zrecore/Garden_Light_Base_Glosola_HSS1751/models/renders/Glosola_HSS1751.6PK_Base_showcase.png

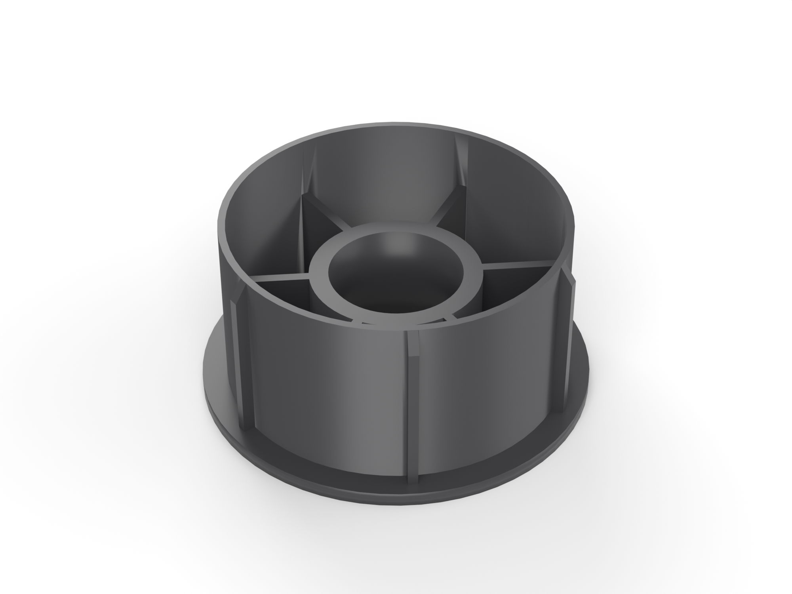
models/renders/Glosola_HSS1751.6PK_Base_showcase.png
