zrecore/Garden_Light_Base_Glosola_HSS1751/models/print/Glosola_HSS1751.6PK-Glosola_HSS1751.6PK_Base.3mf

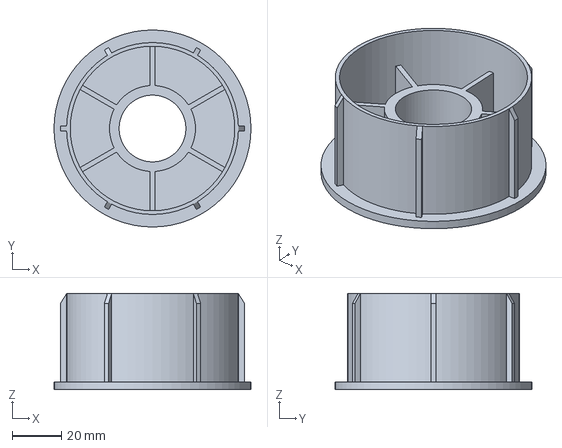
[picture p5: CAD file, 2026-11-03]
models/print/Glosola_HSS1751.6PK-Glosola_HSS1751.6PK_Base.3mf
80.0 x 80.0 x 39.0 mm
