zrecore/Garden_Light_Base_Glosola_HSS1751/(list of files, cad)

Other CAD files:
models/Glosola_HSS1751.6PK.blend
models/print/Glosola_HSS1751.6PK-Glosola_HSS1751.6PK_Base.obj
