zrecore/Garden_Light_Base_Glosola_HSS1751/(commit log)

2026-11-01 Add Glosola HSS1751 solar light model with printable plug
    Blender model of one light from the Glosola 6-pack (Amazon B0FQ2WP9CV),
    generated by a headless Blender script so it can be rebuilt:
    - Body (cap, fluted lens, hollow pipe), base plug and spike as separate
    meshes, true size, scene units in mm, laid out with 200 mm gaps.
    - Plug: flush flange, cup with six wedge ribs and six inner support
    ribs, molded socket; fit sized from test prints.
    - 3D Print Toolbox export script (checks + Z-up OBJ in mm) and the
    current plug OBJ.
    - Preview and fit-check render scripts, a blender3d skill, README.
    [Glosola_HSS1751.6PK-Glosola_HSS1751.6PK_Base.obj, Glosola_HSS1751.6PK.blend]
2026-11-01 Tune plug fit from test prints; move skill to .claude/skills
    Plug (sizes across, mm), adjusted over several test prints:
    - Rib tips 74.41 on 2.5 mm ribs (outer wall 69.41), so the plug slides
    into the slightly out-of-round metal pipe with a snug fit.
    - Stake hole 27.80, set directly by BORE_D (independent of the socket
    wall, which is now just the result: 3.55 mm with the socket outside
    fixed at 34.90).
    - Rib sliver fix: wedge-rib lead-ins end inside the polygonal wall.
    - Plug OBJ re-exported (Z-up, mm, 3D Print Toolbox checks clean), plus
    the Bambu Studio project file saved alongside it.
    Skill: blender3d moved to .claude/skills/ so Claude Code loads it
    automatically; scripts referen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
    [Glosola_HSS1751.6PK-Glosola_HSS1751.6PK_Base.3mf, Glosola_HSS1751.6PK-Glosola_HSS1751.6PK_Base.obj, Glosola_HSS1751.6PK.blend]
2026-11-02 Tighten plug stake hole to 27.60 mm
    Stake hole 27.80 -> 27.60 mm across (BORE_D), still a little loose
    after the last test print. The socket's outside stays at 34.90 mm, so
    the socket wall is now 3.65 mm. Rib tips (74.41) and outer wall (69.41)
    are unchanged.
    Plug OBJ re-exported (Z-up, mm, 3D Print Toolbox checks clean), README
    and preview renders updated, Bambu Studio project file refreshed.
    [Glosola_HSS1751.6PK-Glosola_HSS1751.6PK_Base.3mf, Glosola_HSS1751.6PK-Glosola_HSS1751.6PK_Base.obj, Glosola_HSS1751.6PK.blend]
2026-11-02 Working model for the Glosola HSS1751 base.
    [Glosola_HSS1751.6PK-Glosola_HSS1751.6PK_Base.3mf, Glosola_HSS1751.6PK-Glosola_HSS1751.6PK_Base.obj, Glosola_HSS1751.6PK.blend]
2026-11-03 Final plug fit, showcase render and render script
    Plug (sizes across, mm), tuned over further test prints and confirmed
    by the user as a snug fit: rib tips 74.81 (outer wall 69.81, 2.5 mm
    ribs), stake hole 27.10, socket outside 34.90 (wall 3.90). Plug OBJ
    re-exported (Z-up, mm, 3D Print Toolbox checks clean); README, preview
    renders and the Bambu Studio project file refreshed.
    Add render_showcase.py to the blender3d skill: a Cycles studio render of
    one object on a pure white background (charcoal ABS look, soft lights,
    contact shadow), and the 2000x1500 showcase render of the plug for the
    Bambu Lab project page.
    [Glosola_HSS1751.6PK-Glosola_HSS1751.6PK_Base.3mf, Glosola_HSS1751.6PK-Glosola_HSS1751.6PK_Base.obj, Glosola_HSS1751.6PK.blend]
2026-11-03 Adding Bambu Studio 3mf file
    [Glosola_HSS1751.6PK-Glosola_HSS1751.6PK_Base.3mf]
